k0swe/ft232r-eval/README.md

Evaluation board for the FTDI FT232R USB to serial chip.
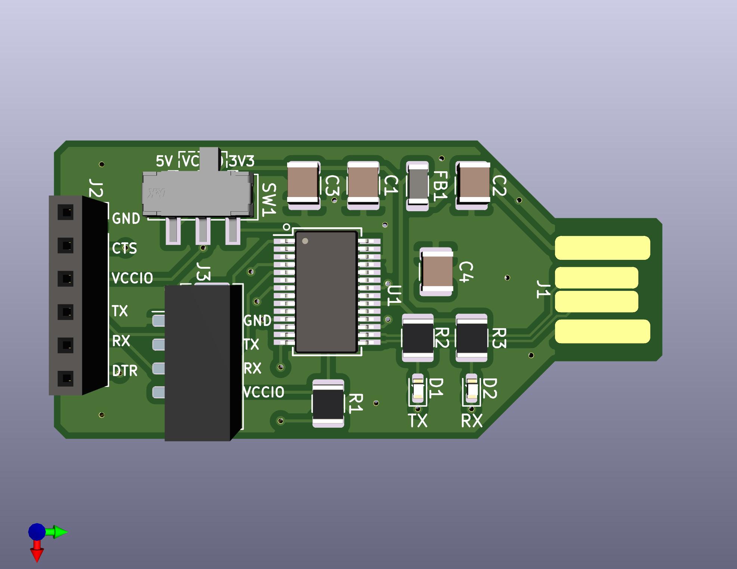
[picture p1: render.jpg]
Render
