k0swe/ft232r-eval/ft232r-eval.pdf

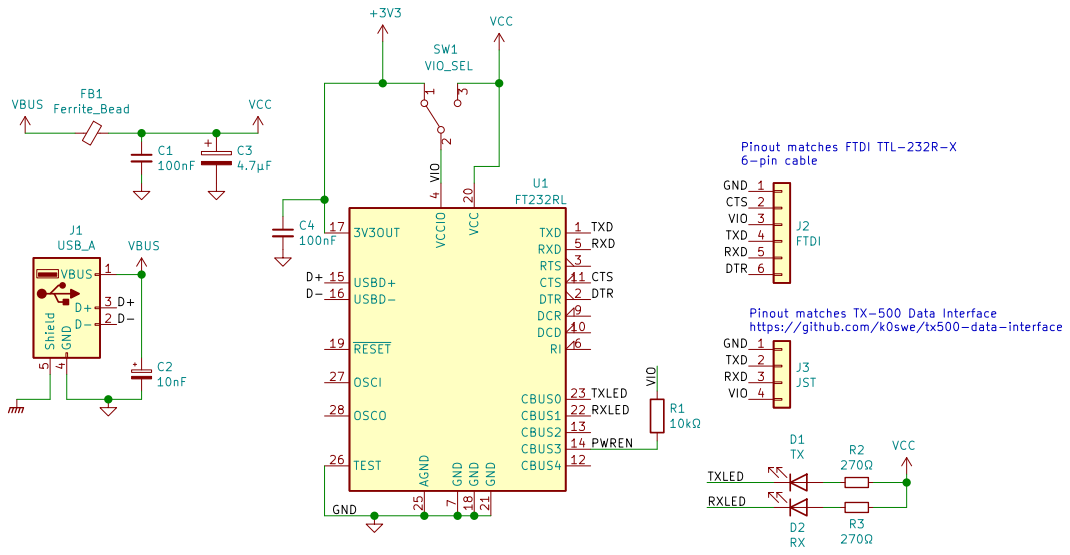
[picture p2: page 1]

File: ft232r-eval.sch Sheet: / Chris Keller Licensed under Creative Commons CC-BY-4.0

Id: 1/1 Title: FT232R Evaluation Board
