k0swe/ft232r-eval/ft232r-eval.kicad_pcb

## KiCad design ft232r-eval.kicad_pcb (2021-04-24)

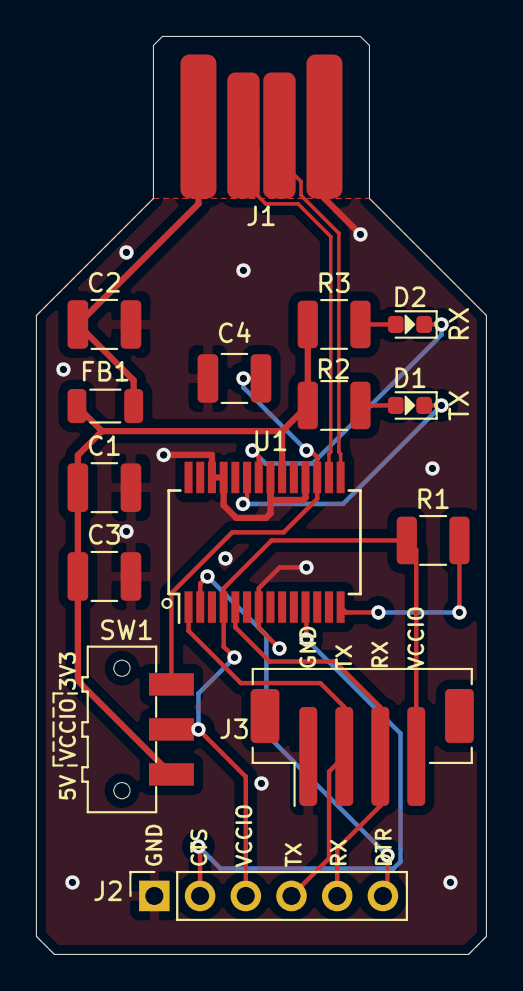
[picture p3: board ft232r-eval.kicad_pcb from above]

Board: 2 copper layers, 25.0 x 51.0 mm, 16 parts (1 on the bottom side), 16 nets.

Parts:
C1, C4: 100nF; C_1210_3225Metric
C2: 10nF; C_1210_3225Metric
C3: 4.7μF; C_1210_3225Metric
D1: TX; LED_0603_1608Metric
D2: RX; LED_0603_1608Metric
FB1: Ferrite_Bead; L_1206_3216Metric
J1: USB_A; USB-A_trace
J2: FTDI; PinSocket_1x06_P2.54mm_Vertical
J3: JST; JST_PH_B4B-PH-SM4-TB_1x04-1MP_P2.00mm_Vertical
LOGO1: Logo_Open_Hardware_Small; OSHW-Logo2_9.8x8mm_SilkScreen
R1: 10kΩ; R_1210_3225Metric
R2, R3: 270Ω; R_1210_3225Metric
SW1: VIO_SEL; SW_SPDT_CK-JS102011SAQN
U1: FT232RL; SSOP-28_5.3x10.2mm_P0.65mm

Connections:
+3V3: C4.1, SW1.1, U1.17
/CTS: J2.2, U1.11
/D+: J1.3, U1.15
/D-: J1.2, U1.16
/DTR: J2.6, U1.2
/PWREN: R1.2, U1.14
/RXD: J2.5, J3.3, U1.5
/RXLED: D2.1, U1.22
/TXD: J2.4, J3.2, U1.1
/TXLED: D1.1, U1.23
/VIO: J2.3, J3.4, R1.1, SW1.2, U1.4
GND: C1.2, C2.2, C3.2, C4.2, J1.4, J2.1, J3.1, U1.7, U1.18, U1.21, U1.25, U1.26
unnamed: D1.2, R2.1
unnamed: D2.2, R3.2
VBUS: C2.1, FB1.2, J1.1
VCC: C1.1, C3.1, FB1.1, R2.2, R3.1, SW1.3, U1.20
