k0swe/ft232r-eval/(threads)

Thread 1 (2021-05-03):

PCB edge USB-A connector isn't very functional as-is

xylo04, 2021-05-03:
I assumed that a standard 1.6 mm thick board would work well as a USB-A plug, but it turns out that doesn't stay connected very well in a standard USB-A socket because it's not thick enough. Measuring my Yubikeys, I get more like 2.4 mm for a snug and reliable connection. This is corroborated by [this article](https://www.hackster.io/news/midi-interface-business-card-pcb-f7ddfdefdbf6): "Cleverly, the board is made 1mm thin, with a tab that breaks off to double the thickness of the USB port section as an interface."
