k0swe/ft232r-eval/(commit log)

2021-03-24 Fix FTDI header footprint
    [bom.csv, ft232r-eval.kicad_pcb, ft232r-eval.sch]
2021-04-01 Fix JST part number
    Adafruit 4392 is horizontal, not vertical.
    [bom.csv]
2021-04-03 Add labels for J2 and J3 pins
    [ft232r-eval.kicad_pcb, ft232r-eval.sch]
2021-04-04 Convert BOM from one per line to grouped
    [bom.csv]
2021-04-05 Thicker traces and fix 3D render
    [ft232r-eval.kicad_pcb, ft232r-eval.sch]
2021-04-07 Add LED directional arrows
    [ft232r-eval.kicad_pcb]
2021-04-14 Clean up libraries
    [ft232r-eval.kicad_pcb]
2021-04-15 License under CC BY 4.0
    [ft232r-eval.kicad_pcb, ft232r-eval.sch]
2021-04-19 Small updates
    [ft232r-eval.kicad_pcb, ft232r-eval.sch]
2021-04-19 Change BOM from grouped to one line per component
    [bom.csv]
2021-04-24 Add OSHW logo
    [ft232r-eval.kicad_pcb, ft232r-eval.sch]
